raymirabel/HMI/CNMB5_I2C/Doc/HMI_CNMB_I2C_2.jpg

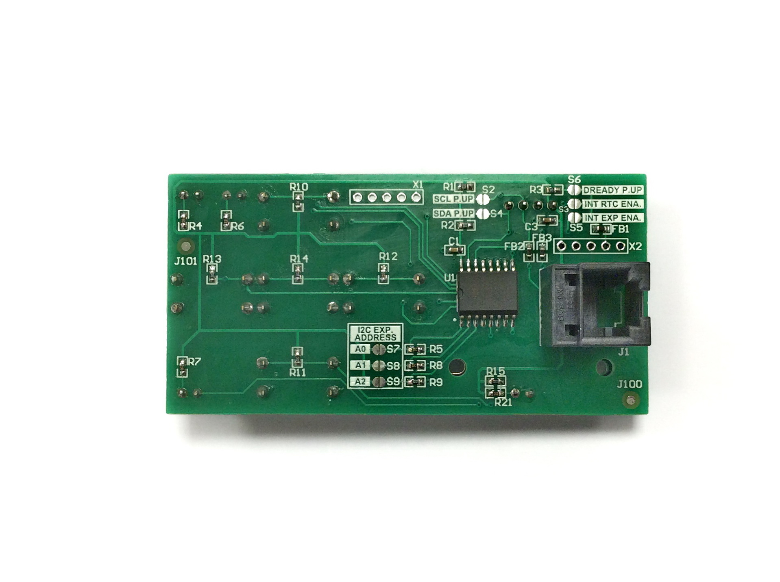
CNMB5_I2C/Doc/HMI_CNMB_I2C_2.jpg
