raymirabel/HMI/CNMB5_I2C/Doc/HMI_CNMB_I2C_RTC.jpg

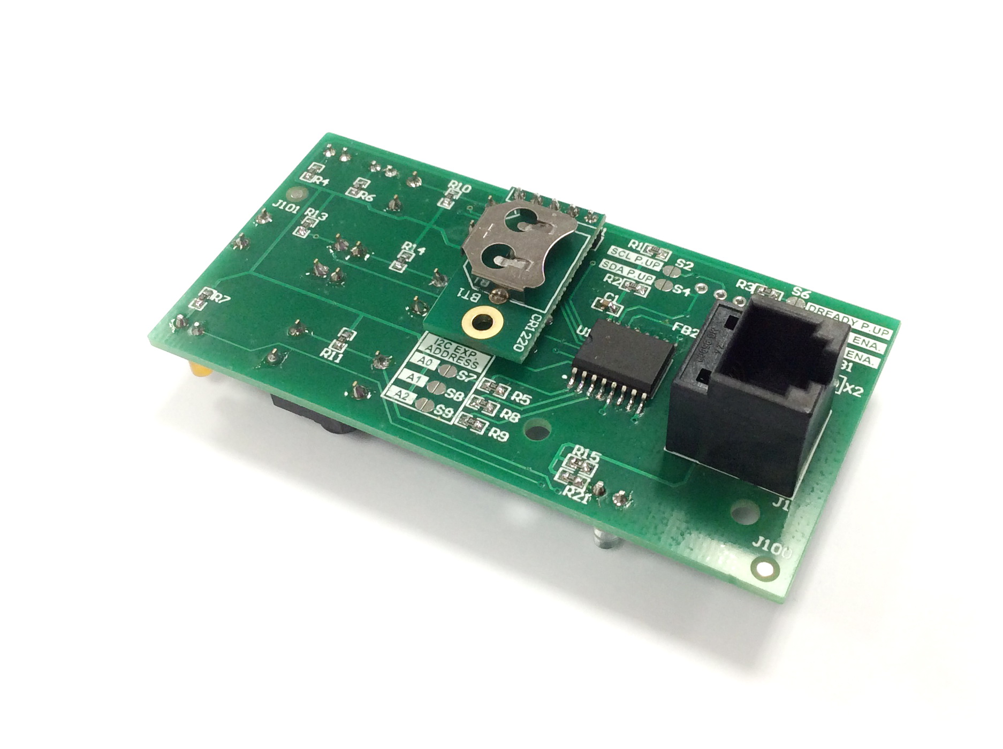
CNMB5_I2C/Doc/HMI_CNMB_I2C_RTC.jpg
