raymirabel/HMI/CNMB5_I2C/Doc/CNMB5_SCHEMATIC.pdf

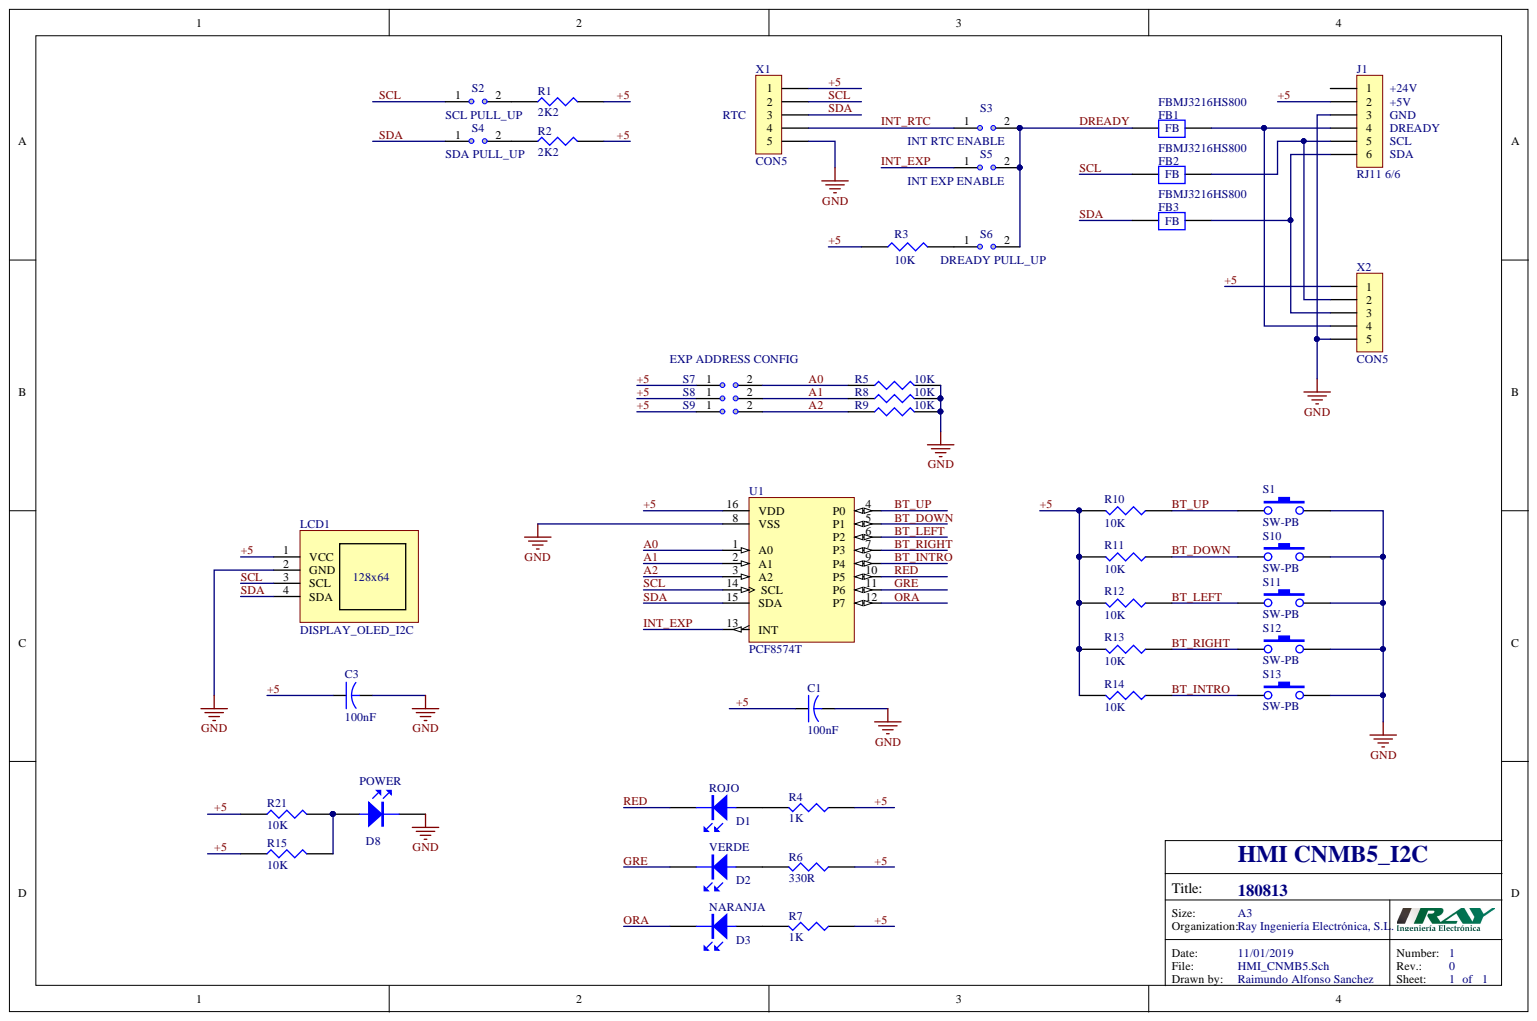
[picture p4: page 1]

VCC 1 GND 2

SCL SDA | SCL 3 SDA 4

Size: A3 Organization: Ray Ingeniería Electrónica, S.L.

Date: 11/01/2019 File: HMI_CNMB5.Sch Drawn by: Raimundo Alfonso Sanchez | Number: 1 Rev.: 0 Sheet: 1 of 1
