raymirabel/HMI/CNMB5/OLED.pdf

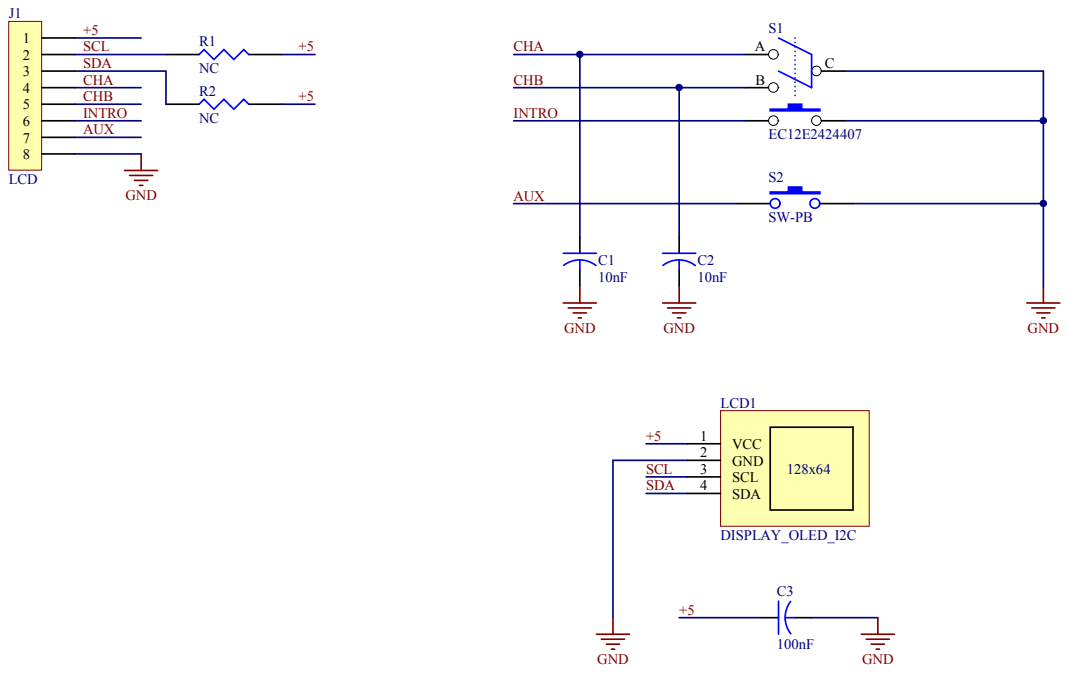
[picture p5: page 1]

VCC 1 GND 2

SCL SDA | SCL 3 SDA 4

Size: A3 Organization: Ray Ingeniería Electrónica, S.L.

Date: 27/09/2016 File: OLED.Sch Drawn by: Raimundo Alfonso Sanchez | Number: 1 Rev.: 0 Sheet: 1 of 1
